briangunderson/ROScar1/docs/chassis/fusion360/bracket_stls/motor_bracket_25GA20E260.stl

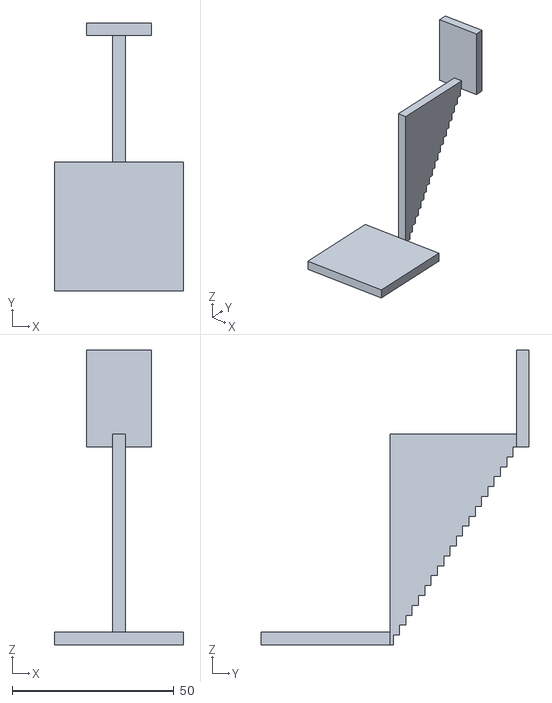
[picture p1: CAD file, 2026-04-20]
docs/chassis/fusion360/bracket_stls/motor_bracket_25GA20E260.stl
40.0 x 83.0 x 91.2
