briangunderson/ROScar1/docs/chassis/models/brackets/L-Plate 3030 5 Holes - M6.step

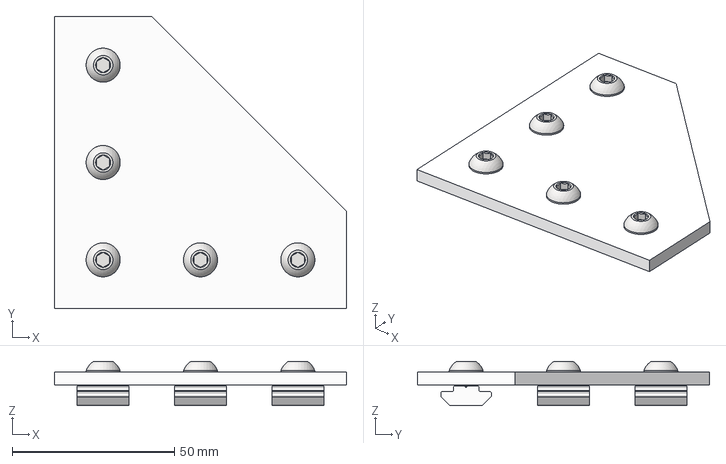
[picture p2: CAD file, 2026-04-17]
docs/chassis/models/brackets/L-Plate 3030 5 Holes - M6.step
90.0 x 90.0 x 13.6 mm
Slider T-Nut for 3030 - M6 x 5
M6x1x10mm - Button Head Hex Drive Screw x 5
