briangunderson/ROScar1/docs/chassis/models/extrusions/30X30 - T-slot - Aluminium Profile.step

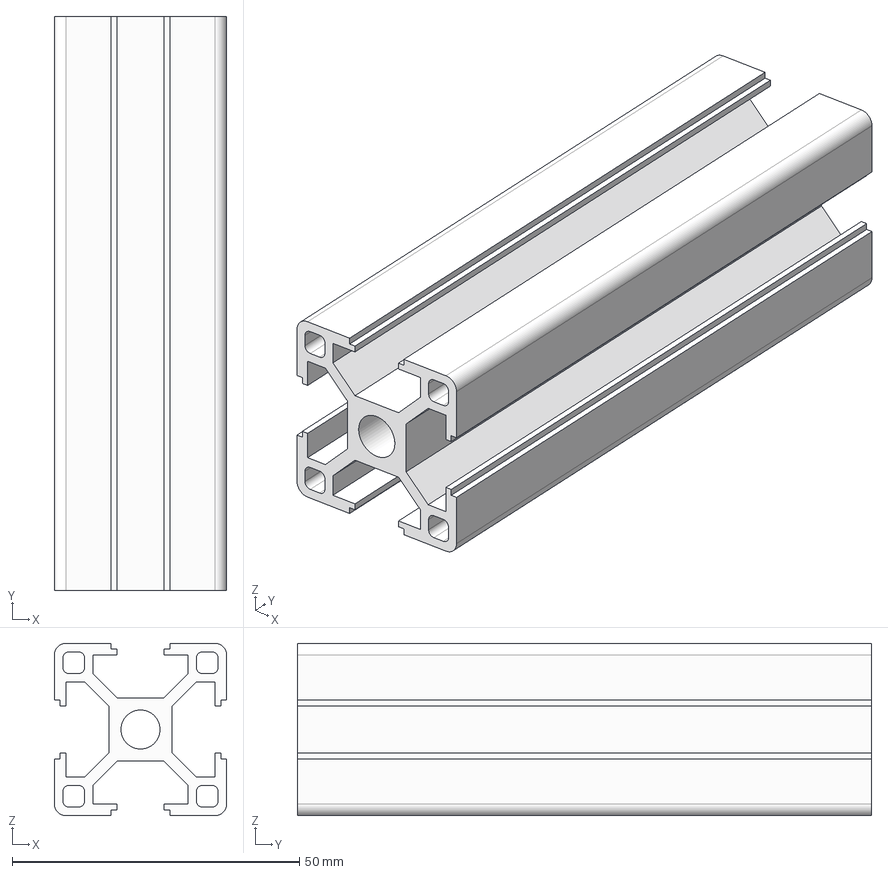
[picture p3: CAD file, 2026-04-17]
docs/chassis/models/extrusions/30X30 - T-slot - Aluminium Profile.step
30.0 x 100.0 x 30.0 mm
