briangunderson/ROScar1/docs/chassis/models/brackets/T-Plate 3030 5 Holes - M5.step

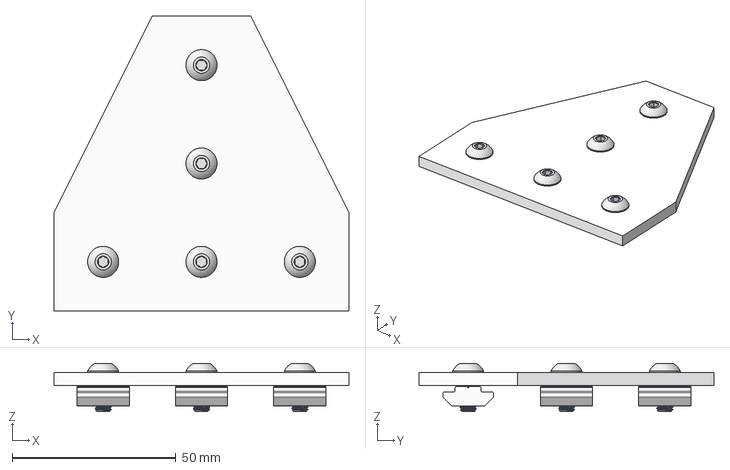
[picture p4: CAD file, 2026-04-17]
docs/chassis/models/brackets/T-Plate 3030 5 Holes - M5.step
90.0 x 90.0 x 14.8 mm
Slider T-Nut for 3030 - M5 x 5
M5x0.8x12mm - Button Head Hex Drive Screw x 5
