briangunderson/ROScar1/docs/chassis/models/brackets/3030 - 3-way corner bracket.step

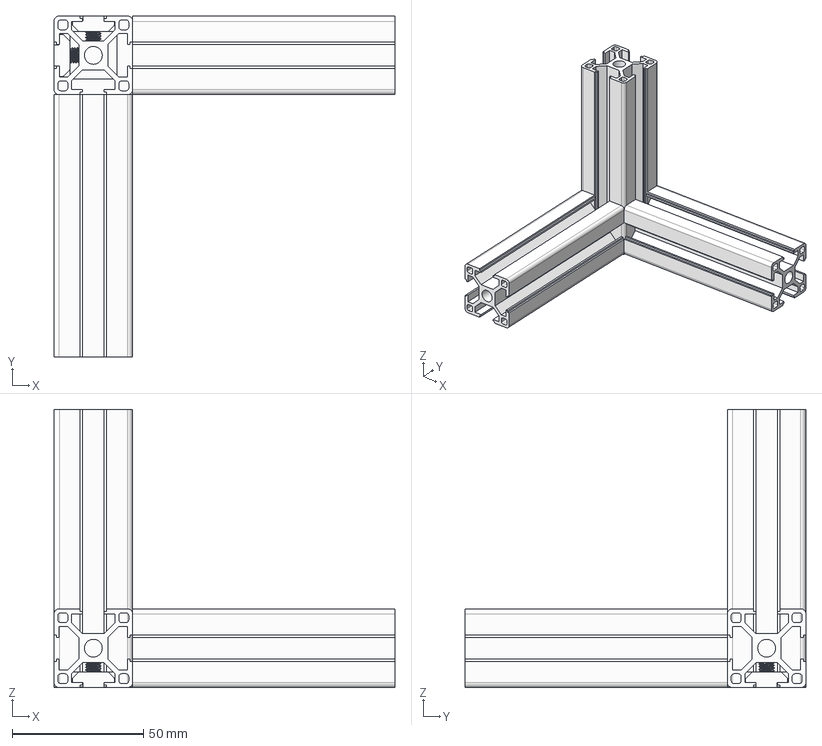
[picture p5: CAD file, 2026-04-17]
docs/chassis/models/brackets/3030 - 3-way corner bracket.step
130.0 x 130.0 x 106.0 mm
M6x1x10 - Flat-Tip Set Screw (1) x 4
30X30 - T-slot - aluminium profile_1 x 3
