briangunderson/ROScar1/docs/chassis/models/brackets/T-Plate 3030 5 Holes - M6.step

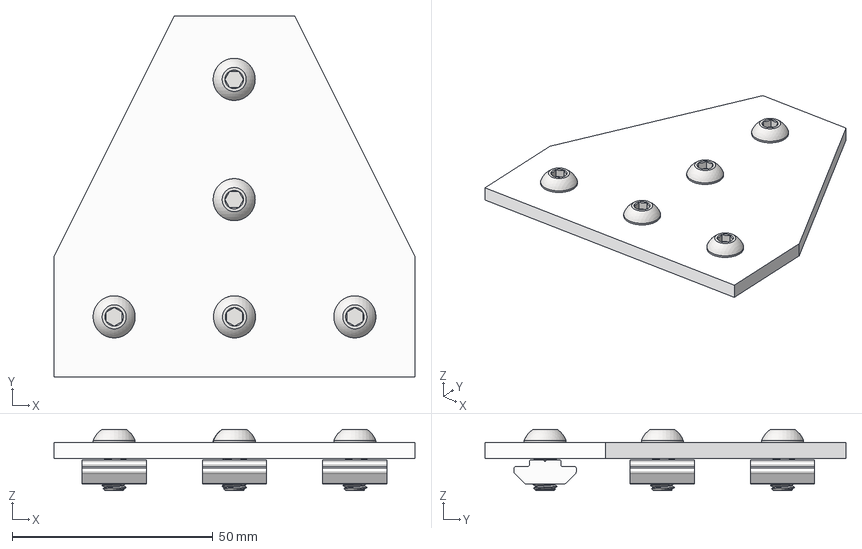
[picture p6: CAD file, 2026-04-17]
docs/chassis/models/brackets/T-Plate 3030 5 Holes - M6.step
90.0 x 90.0 x 15.3 mm
M6x1x12mm - Button Head Hex Drive Screw x 5
Slider T-Nut for 3030 - M6 x 5
