briangunderson/ROScar1/docs/chassis/models/fasteners/Slider T-Nut for 3030 - M3.step

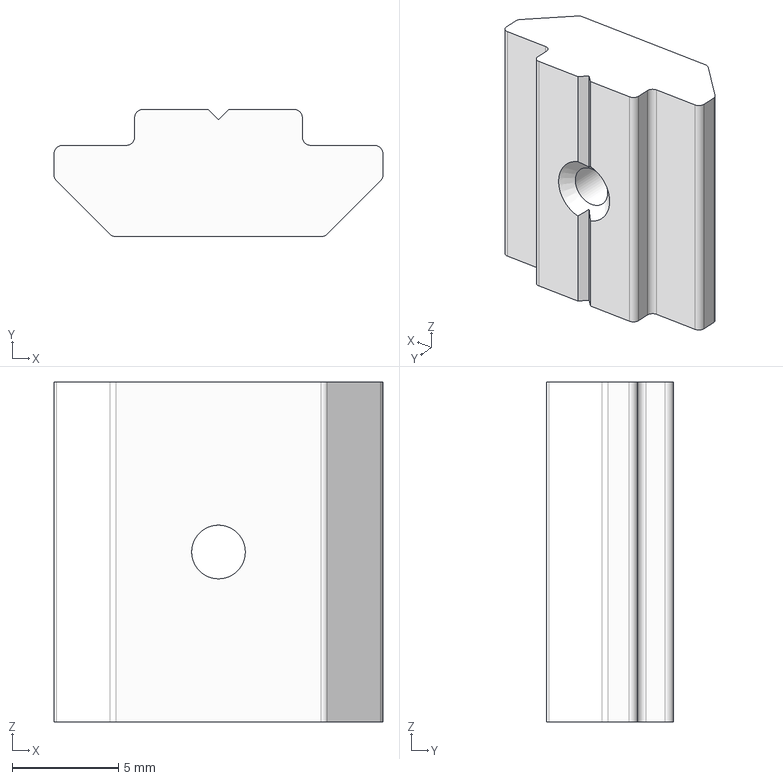
[picture p8: CAD file, 2026-04-17]
docs/chassis/models/fasteners/Slider T-Nut for 3030 - M3.step
15.5 x 6.00 x 16.0 mm
