briangunderson/ROScar1/(list of files, cad)

Other CAD files:
docs/chassis/models/fasteners/Slider T-Nut for 3030 - M5.step
docs/chassis/models/fasteners/Slider T-Nut for 3030 - M6.step
docs/chassis/models/brackets/3030 - 3-way corner bracket.iges
docs/chassis/models/brackets/L-Plate 3030 5 Holes - M6.iges
docs/chassis/models/brackets/T-Plate 3030 5 Holes - M5.iges
docs/chassis/models/brackets/T-Plate 3030 5 Holes - M6.iges
docs/chassis/models/extrusions/30X30 - T-slot - Aluminium Profile.f3d
docs/chassis/models/extrusions/30X30 - T-slot - Aluminium Profile.iges
docs/chassis/models/fasteners/Slider T-Nut for 3030 - M3.f3d
docs/chassis/models/fasteners/Slider T-Nut for 3030 - M3.iges
docs/chassis/models/fasteners/Slider T-Nut for 3030 - M4.f3d
docs/chassis/models/fasteners/Slider T-Nut for 3030 - M4.iges
docs/chassis/models/fasteners/Slider T-Nut for 3030 - M5.f3d
docs/chassis/models/fasteners/Slider T-Nut for 3030 - M5.iges
docs/chassis/models/fasteners/Slider T-Nut for 3030 - M6.f3d
docs/chassis/models/fasteners/Slider T-Nut for 3030 - M6.iges
