briangunderson/ROScar1/tasks/todo.md

# ROScar1 - Task Tracker

## Milestone 1: Teleop Ready ✅
- [x] Create workspace structure
- [x] roscar_driver package (driver node, kinematics, config, launch)
- [x] roscar_description package (URDF, launch, rviz)
- [x] roscar_bringup package (launch files, teleop config, EKF config)
- [x] Setup scripts (RPi setup, udev rules)
- [x] CLAUDE.md project documentation
- [x] Deploy to RPi5 and test
- [x] Rosmaster_Lib v3.3.9 installed (pip from github.com/Roblibs/Rosmaster_Lib)
- [x] All 6 nodes running: driver, robot_state_publisher, joint_state_publisher, sllidar, imu_filter, ekf
- [x] Teleop driving confirmed working

## Milestone 2: Camera Integration ✅
- [x] v4l2_camera launch (fixed image_size param type — OpaqueFunction for int cast)
- [x] Camera link in URDF (camera_link + camera_optical_frame already in xacro)
- [x] Test image streaming (/image_raw at 30fps, /camera_info publishing)

## Milestone 3: Sensor Fusion ✅
- [x] Fix IMU sign conventions (negate all accel axes, negate only gx/gy for gyro)
- [x] Fix conflicting odom TFs (driver publish_odom_tf=false, EKF owns TF)
- [x] EKF config: velocity-only from odom, 20Hz, differential IMU yaw
- [x] IMU Madgwick filter: fixed_frame=odom, gain=0.1, orientation correct (flat=identity)
- [x] Verified: 0 NaN errors, position stable at origin when stationary, all topics 20Hz

## Milestone 4: SLAM + Navigation
- [x] slam_toolbox config (online_async, 5cm resolution, RPLIDAR C1 tuned)
- [x] Nav2 config (DWB holonomic controller, SmacPlanner2D, AMCL OmniMotionModel, RPi5-tuned)
- [x] slam.launch.py (SLAM-only mapping with teleop)
- [x] navigation.launch.py (saved map + AMCL + Nav2)
- [x] slam_nav.launch.py (SLAM + Nav2 combined for explore-and-navigate)
- [x] Package deps updated (slam_toolbox, navigation2, nav2_bringup)
- [x] setup_rpi.sh updated with new apt packages
- [x] Deploy to RPi5 and test SLAM mapping (lifecycle fix: nav2_lifecycle_manager + bond_timeout=0.0)
- [x] SLAM verified: /map publishing (74×135 cells @ 5cm), map->odom TF, all 8 nodes running
- [ ] Save first map and test Nav2 navigation
- [ ] Verify holonomic motion (strafing) during navigation
