briangunderson/ROScar1/roscar_ws/src/roscar_web/config/web_params.yaml

rosbridge_websocket:
  ros__parameters:
    port: 9090
    address: "0.0.0.0"
    retry_startup_delay: 5.0
    fragment_timeout: 600
    delay_between_messages: 0.0
    max_message_size: 10000000
    unregister_timeout: 10.0

web_video_server:
  ros__parameters:
    port: 8080
    address: "0.0.0.0"
    default_stream_type: "mjpeg"
    ros_threads: 2

http_server:
  ros__parameters:
    port: 8888
