briangunderson/ROScar1/(commit log)

2026-03-02 Milestone 1: Teleop-ready ROS2 workspace for 4WD Mecanum robot
    Complete ROS2 Jazzy workspace with three packages:
    - roscar_driver: Python node bridging cmd_vel/sensors to YB-ERF01-V3.0
    via Rosmaster_Lib (serial 115200). Publishes odom, IMU, battery.
    - roscar_description: URDF (placeholder dims) with mecanum wheels,
    camera, IMU, and RPLIDAR C1 laser frames.
    - roscar_bringup: Launch files for teleop, robot bringup (driver +
    lidar + Madgwick IMU filter + EKF), and camera.
    Includes RPi5 setup script, udev rules for motor board + RPLIDAR C1,
    and EKF/IMU filter configurations.
    [roscar.urdf.xacro]
2026-03-02 Fix forward direction: board X-axis is 180° from physical front
    Camera and lidar are mounted on the board's rear. Negate vx/vy at the
    hardware boundary (commands to board and sensor data from board) so that
    ROS +X points toward the camera/lidar. Angular-z and vertical axes are
    unaffected by a yaw-only rotation.
2026-03-02 Fix reversed turning: negate wz for swapped L/R motor ports
    Translation (vx, vy) was correct but rotation was reversed, indicating
    the left/right motor pairs are swapped on the board's ports. Negate wz
    in commands and odometry, and gz in gyro data to compensate.
2026-03-02 Update lessons with final motor wiring notes
    All axes negated at hardware boundary: board is mounted 180° rotated
    AND motor L/R ports are swapped. Confirmed driving correctly in all
    directions including rotation.
2026-03-02 Fix camera.launch.py image_size parameter type error
    v4l2_camera expects image_size as integer_array, but LaunchConfiguration
    substitutions resolve to strings. Use OpaqueFunction to cast to int.
2026-03-02 Mark Milestone 2 complete, add camera + launch file lessons
    Camera integration verified: /image_raw at 30fps, /camera_info publishing.
    Added lessons about v4l2_camera parameter typing and OpaqueFunction pattern.
2026-03-02 Fix sensor fusion: IMU signs, conflicting TFs, EKF config
    - Accel: negate all 3 axes (Rosmaster_Lib reports gravity as -Z,
    ROS expects +9.81 when flat)
    - Gyro: only negate gx, gy (180-deg yaw rotation); keep gz as-is
    (Z-axis direction unchanged by yaw rotation)
    - Disable driver's odom TF (publish_odom_tf: false); EKF now owns
    the odom->base_footprint transform
    - EKF: use velocity-only from odom (position was double-counting),
    lower frequency to 20Hz to avoid rate warnings on Pi
    - IMU filter: fix fixed_frame from base_link to odom
    Previous bugs: Madgwick saw az=-9.8 and concluded robot was upside
    down (180-deg roll), feeding garbage orientation to EKF which went
    NaN. Negated gz also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
2026-03-02 Mark Milestone 3 complete, update docs with sensor fusion details
    All sensor fusion issues resolved: IMU signs corrected (accel z, gyro z),
    conflicting TFs eliminated, EKF velocity-only odom fusion. Verified:
    0 NaN errors, stable position when stationary, all topics at 20Hz.
2026-03-03 Add SLAM + Nav2 configuration (Milestone 4)
    - slam_toolbox online_async config (5cm resolution, RPLIDAR C1 tuned)
    - Nav2 params: DWB holonomic controller, SmacPlanner2D, AMCL OmniMotionModel
    - Three launch modes: slam.launch.py, navigation.launch.py, slam_nav.launch.py
    - RPi5-tuned frequencies (controller 10Hz, costmaps 5Hz/1Hz)
    - Updated package deps, setup script, and documentation
2026-03-03 Add web dashboard: roscar_interfaces + roscar_web packages
    New packages:
    - roscar_interfaces: custom .srv files (SetMode, SaveMap, GetStatus)
    - roscar_web: web dashboard with rosbridge/video/http nodes + full frontend
    Frontend (vanilla JS, no build step):
    - Industrial mission-control aesthetic (dark navy + cyan)
    - Drive tab: dual nipplejs joystick (holonomic vx/vy/wz) + keyboard WASD/QE
    - Camera tab: MJPEG stream from web_video_server
    - Map tab: OccupancyGrid canvas renderer + robot pose + click-to-navigate
    - Status tab: odometry, IMU, battery gauge, active node list
    - Settings tab: mode switching (idle/teleop/slam/nav/slam_nav), map save
    - E-STOP button + Spacebar shortcut
    Backend:
    - laun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
    [web_params.yaml]
2026-03-03 Fix rosbridge param: delay_between_messages must be DOUBLE (0.0 not 0)
    [web_params.yaml]
2026-03-03 fix(web): rotate map view 90° CCW so forward (ROS +X) points UP
    The OccupancyGrid renderer was mapping ROS +X to screen RIGHT, causing
    the robot arrow to appear to move side-to-side when driving forward.
    Now forward→UP, left→LEFT matching standard top-down robot view.
    Changed: drawMap canvas transform, drawRobotPose world-to-screen,
    fitMapToCanvas dimension swap, sendNavGoal inverse transform.
2026-03-03 fix(driver): add gyro bias calibration to eliminate yaw drift
    MEMS gyroscopes have a small non-zero offset when stationary. Without
    compensation, this bias integrates through Madgwick + EKF into continuous
    yaw drift. Samples gyro at ~100Hz for 2s at startup (configurable via
    gyro_cal_seconds param), computes mean bias, subtracts it from all
    subsequent readings before the 180° rotation correction.
2026-03-03 feat(driver): add yaw_trim parameter for steering correction
    Compensates for mechanical pull (uneven wheel friction, motor mismatch,
    weight distribution) when driving straight. Trim is proportional to
    forward speed so it scales naturally and reverses when backing up.
    Tunable at runtime: ros2 param set /roscar_driver yaw_trim <value>
2026-03-06 fix(nav2): add laser range filter to eliminate chassis self-reflections
    RPLIDAR C1 sees ~145 scan points from robot chassis at 0.02-0.09m range,
    which slam_toolbox bakes into the map as permanent obstacles at the robot
    position, causing Nav2 planner "Start occupied" errors.
    - Add laser_filter.yaml: LaserScanRangeFilter drops returns < 0.15m
    - Modify robot.launch.py: sllidar publishes /scan_raw, laser_filter_node
    filters and republishes as /scan
    - Fix URDF laser joint: add pi yaw for 180-deg mounted RPLIDAR
    - Add rviz2 Tools section: 2D Goal Pose, SetInitialPose, etc.
    - Set obstacle_min_range: 0.20 on both costmap obstacle layers
    [roscar.urdf.xacro]
2026-03-06 fix(laser_filter): use ROS2 param YAML format instead of sequence
    laser_filters scan_to_scan_filter_chain expects ros__parameters with
    numbered filter keys (filter1, filter2), not YAML list syntax.
2026-03-06 docs: add laser filter and nav2 goal testing lessons
    - Document lidar self-reflection filtering with laser_filters
    - Document Nav2 progress checker tuning for slow robots
    - Update CLAUDE.md: nav2 goal verified, laser_filter in critical files
    - Add scan_raw/scan pipeline to topics table
2026-03-06 fix(nav2): expand collision_monitor polygons to prevent false stops
    The PolygonStop zone matched the robot footprint exactly (0.15m), causing
    nearby wall returns at 0.15-0.20m to trigger emergency stops on every
    navigation attempt. Expanded to 0.20m with min_points=8, and added a
    PolygonSlow zone at 0.30m for gradual deceleration near obstacles.
2026-03-06 feat(nav2): triple velocity limits for faster navigation
    DWB and velocity_smoother limits tripled: max_vel_x 0.5→1.5,
    max_vel_y 0.3→0.9, max_vel_theta 2.0→4.0, accel limits raised to match.
2026-03-06 feat: update for top-mounted lidar — remove laser filter
    Lidar moved from middle platform to top platform with clear 360-degree
    view. Updated URDF lidar_z (0.12→0.09), removed laser_filter_node from
    robot.launch.py (no more chassis self-reflections), and reset costmap
    obstacle_min_range to 0.0.
    [roscar.urdf.xacro]
2026-03-06 fix(nav2): dial back velocity to safe levels (0.8 m/s max)
    1.5 m/s was too aggressive — robot crashed into desk. Reduced to 0.8 m/s
    forward, 0.5 m/s strafe, 3.0 rad/s rotation. Still ~60% faster than the
    original 0.5/0.3/2.0 defaults.
2026-03-11 fix: motor wiring corrections, EKF bypass Madgwick, decel limiter, web dashboard improvements
    Motor wiring physically corrected — all 4 motors now match board port labels
    with correct polarity. Driver simplified: removed all cmd_vel and odometry
    sign corrections. Added deceleration limiter to prevent tip-overs on abrupt stops.
    EKF now uses imu/data_raw directly (bypasses broken Madgwick orientation).
    Driver sets identity quaternion on imu/data_raw so robot_localization's
    frame transform is a no-op. Negates all 3 gyro axes (gz firmware inversion).
    Web dashboard: added rosapi node for getNodes(), fixed camera.js URL encoding
    bug (web_video_server doesn't decode %2F), updated roslibjs, adde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
    [motor_test.py]
2026-03-11 docs: add AIO dashboard implementation plan
    12-task plan covering HTML skeleton, CSS Grid, all 8 JS modules
    (app, teleop+gamepad, camera, status+modes, map, lidar, graphs,
    diagnostics, TF tree), integration testing, and docs.
2026-03-11 feat(aio): add HTML skeleton and CSS Grid layout
    Create the AIO (all-in-one) mission-control dashboard with a 3-column,
    2-row CSS Grid layout showing all panels simultaneously. Includes:
    - Camera feed panel with quality/resolution controls
    - Map panel with canvas, zoom controls, and nav goal UI
    - Status panel with position/velocity/orientation/battery/mode/map-save
    - Drive panel with dual joystick zones, sliders, kbd hints, lidar canvas
    - Telemetry panel with 4 sparkline canvases and TF tree section
    - Diagnostics panel with severity filter and scrollable log container
    - Shared: E-STOP button, toast notifications, scanline CRT overlay
    CSS is standalone (no style.css import), uses same indust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
2026-03-11 feat(aio): add MJPEG camera stream panel
2026-03-11 feat(aio): add status readouts, mode switching, and map save
2026-03-11 feat(aio): add lidar mini-radar panel
2026-03-11 fix(web): AIO dashboard integration bugs — nav goal wiring, CSS class, message types
    - Wire enableNavGoalMode from aio-map to onNavModeChange in aio-status via aio-app
    - Fix status message CSS class ('mode-status-msg' → 'status-msg')
    - Fix rosout message type ('rcl_interfaces/msg/Log' → 'rcl_interfaces/Log')
    - Fix TF message type ('tf2_msgs/msg/TFMessage' → 'tf2_msgs/TFMessage')
    - Remove unused HOST import from aio-status
    - Fix initStatus() call (was passing unnecessary getRos arg)
2026-03-11 fix(web): camera quality/resolution buttons not rebuilding stream URL
    Two issues fixed in aio-camera.js:
    1. Button clicks only called startStream() when `streaming` was true.
    Since the AIO dashboard camera panel is always visible (no tab switch),
    if the initial connection failed or hadn't completed yet, clicking
    quality/resolution buttons would update the JS state and active class
    but never actually rebuild the MJPEG stream URL. Now startStream() is
    called unconditionally on every button click.
    2. JS default values (quality=50, resolution=640x480) didn't match the
    HTML active buttons (quality=20/L, resolution=320x240). This meant
    the initial stream URL used different s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
2026-03-11 fix(web): fetch current mode on connect so UI survives page refresh
    On page load/refresh the AIO dashboard defaulted to showing "idle" mode
    even when the robot was running in another mode (e.g. slam_nav). Added a
    /web/get_status service call in setupServices() that runs on every
    rosbridge connect event, syncing the mode display, button active state,
    and nav-goal enablement with the actual launch_manager state.
2026-03-11 fix(web): remove CRT scanline overlay from camera panel
    The body::after scanline effect (z-index: 9999) was bleeding into
    the camera feed. Lift #panel-camera above the overlay with
    z-index: 10000 so the video stream renders clean.
2026-03-11 fix(web): zoom map toward mouse cursor instead of top-left corner
    Scroll-wheel zoom now adjusts viewOffset so the world point under the
    cursor stays fixed, giving natural zoom-to-cursor behavior. Zoom-in
    and zoom-out buttons use the same logic targeting the canvas center.
    Extracted a shared zoomAtPoint(factor, cx, cy) helper that computes
    the world coordinate under the given canvas point, applies the scale
    factor, then re-derives the offset to keep that point anchored.
2026-03-11 fix(web): use SLAM-corrected pose for map robot overlay
    Add ROSLIB.TFClient subscribing to the map->odom->base_footprint
    TF chain so the robot arrow on the map stays aligned with the
    SLAM-corrected pose instead of drifting with raw EKF odometry.
    When SLAM is running, slam_toolbox publishes a map->odom correction
    that /odometry/filtered doesn't include. The TFClient automatically
    composes the full chain. Falls back to /odometry/filtered when the
    map frame isn't available (e.g. no SLAM running).
2026-03-11 feat(web): add Reset Map button to AIO dashboard
    Cycles SLAM mode (idle → restore) to restart slam_toolbox with a fresh
    map. Clears local map data immediately for responsive UI feedback.
    Only enabled when in SLAM or SLAM+NAV modes.
2026-03-11 fix(web): move scanline overlay to per-panel ::after, exclude camera
    body::after with position:fixed creates a stacking context that can't
    be overridden by z-index on grid children. Instead, apply scanlines
    via .panel::after on each panel and disable on #panel-camera.
2026-03-11 feat(web): add robot-locked map view with heading-up rotation
    Toggle (lock icon) on the map panel switches between free pan/zoom and
    robot-centered mode where the robot is fixed at canvas center always
    facing up. The map rotates underneath to match the robot's heading,
    like a car GPS. Zoom still works; pan is disabled while locked.
    Nav2 click-to-navigate accounts for the rotated view transform.
2026-03-11 fix(web): use text label for map lock button instead of emoji
    Emoji glyphs may not render in the Rajdhani/Share Tech Mono font stack.
    Use plain 'L' with .active class highlight to indicate locked state.
2026-03-13 docs: add SpaceMouse teleop integration design spec
    WebHID-based 6DOF SpaceMouse Wireless support for AIO dashboard.
    Covers HID protocol, axis mapping, sensitivity curves, priority
    system, E-STOP, secure context workaround, and right joystick fix.
2026-03-13 fix(spacemouse): correct inversion toggle mapping and settings panel ID
    - sm_invert_x now correctly inverts vx (fwd/back), sm_invert_y inverts vy (strafe)
    - Settings panel ID changed to 'sm-settings' to match HTML markup
    - Removed duplicate connect button handler (aio-app.js owns this)
2026-03-13 feat(spacemouse): add UI elements and styles for connect button and settings panel
2026-03-13 fix: address code review findings across SpaceMouse integration
    - Fix right joystick vx clobbering left joystick by separating joyL/joyR
    state objects and summing contributions in publishVelocity()
    - Fix inconsistent indentation in aio-app.js (SM button handler + init)
    - Debounce E-STOP to fire only on rising edge (0→non-zero transition),
    preventing repeated calls while button is held
    - Rescale post-deadzone axis range for smooth zero-to-moving transition
    (was: jump from 0 to deadzone/AXIS_MAX; now: smooth 0 to 1)
    - Remove dead sm-status markup and unused .sm-tag CSS rule
    - Add unit suffixes (m/s, rad/s) to speed slider display values
    - Show device name in connect button text via onC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
2026-03-14 fix(boot): ensure web dashboard survives RPi5 power cycle
    The roscar-web service was crashing on boot because network-online.target
    fires before an IP is assigned, causing CycloneDDS to fail to bind.
    Additionally, ros2 launch exits with code 0 when all child nodes die,
    so Restart=on-failure never triggered a retry.
    - Add network readiness loop (up to 30s) before launching ROS2 nodes
    - Change Restart=on-failure to Restart=always with burst limits
    - Add .gitattributes to enforce LF line endings for Linux scripts
2026-03-14 fix(boot): ensure web dashboard survives RPi5 power cycle
    The roscar-web service was crashing on boot because CycloneDDS couldn't
    initialize — network-online.target fires before DDS can bind, causing
    all ROS2 nodes to fail with "error creating node".
    - Add network readiness loop (waits for default route, up to 30s)
    - Add DDS probe that verifies a ROS2 node can be created before
    launching the full stack (waits up to 30s for DDS to be ready)
    - Change Restart=on-failure to Restart=always with burst limits,
    since ros2 launch exits code 0 even when all child nodes die
    Verified: all 5 nodes start cleanly after cold boot.
    Co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
2026-03-14 feat(web): add sci-fi HUD lidar depth overlay on camera feed
    Projects /scan points within the camera's ~60° FOV onto a canvas overlay,
    rendering depth-coloured bars (red→cyan by distance), a proximity warning
    vignette, nearest-object callout with distance label, sweep animation,
    and HUD chrome (corner brackets, crosshair, FOV label). Toggleable via
    DEPTH button in camera controls.
2026-03-14 feat(web): add clipboard copy and clear to AIO diagnostics panel
    Click any log entry to copy it, COPY button for all visible logs,
    CLR button to clear. Includes fallback for non-HTTPS contexts.
2026-03-14 Add camera calibration data and auto-load in launch
    Logitech webcam (046d:0825) calibrated via ros2 camera_calibration
    with 61 checkerboard images. camera.launch.py now passes
    camera_info_url to v4l2_camera so /camera_info publishes accurate
    intrinsics (fx=924, fy=920, cx=357, cy=253, plumb_bob distortion).
    [camera_calibration.yaml]
2026-03-14 Fix camera calibration name and add io_method for RPi5
    - camera_name must match v4l2 device ID: uvc_camera_(046d:0825)
    - Add io_method=read to avoid YUYV mmap failures on RPi5
    - Verified: /camera_info publishes correct intrinsics and distortion
    [camera_calibration.yaml]
2026-03-14 docs: mark camera calibration and feed fix complete in CLAUDE.md
2026-03-15 Fix EKF divergence: use ROS -1 covariance convention for unused IMU data
    The EKF was exploding (angular.z reaching 10M+ rad/s) because
    robot_localization processed orientation and acceleration data through
    internal code paths (gravity removal, frame transforms) even when those
    fields were disabled in imu0_config.
    Fixes:
    - Set orientation_covariance[0] = -1 (ROS convention: "no orientation data")
    This explicitly tells robot_localization to skip ALL orientation processing
    - Set linear_acceleration_covariance[0] = -1 ("no accel data")
    Prevents internal accel processing paths from executing
    - Set imu0_remove_gravitational_acceleration: false
    Eliminates gravity removal code path (documente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
2026-03-15 Fix camera defaults, robot indicator, and add CV design doc
    - Camera defaults: quality 80 (high), resolution 640x480, matching HTML active states
    - Robot indicator: add TF staleness detection (3s timeout → odom fallback),
    validate TF translations, skip drawing when robot is far outside map grid
    - CV design: approved architecture for ArUco + YOLO on remote RTX 4070 PC
2026-03-15 feat(cv): add aio-cv.js dashboard module with feed toggle and detection overlay
    - New aio-cv.js: subscribes to /detections, shows object summary overlay,
    provides RAW/CV toggle button to switch camera feed topic
    - aio-camera.js: topic now dynamic, listens for cv-feed-change CustomEvent
    - aio-app.js: imports and initializes CV module
    - aio.html: CV toggle button + detection overlay element in camera panel
    - aio.css: detection overlay styling (green text on dark background)
2026-03-15 fix(web): rework lidar depth overlay for cleaner, professional look
    - Remove sci-fi HUD chrome: corner brackets, crosshair, sweep animation,
    FOV label, L/R labels, bottom distance scale
    - Remove pulsing red proximity vignette, replace with subtle edge tint
    - Remove "NEAREST" tag, replace with clean distance pill label
    - Add EMA smoothing to nearest-object callout to prevent jitter
    - Only show nearest label when object is within 2m
    - Restyle color ramp: warm white (close) → light blue → dim steel (far)
    - Thinner bars, subtler opacity, cleaner centre strip
    - Remove drawHUDFrame and drawCorner functions entirely
2026-03-15 fix(web): correct lidar overlay HFOV from 60° to 38.1° using calibration
    HFOV was hardcoded at 60° (a guess). Actual value from camera calibration
    is 2*atan(320/924) ≈ 38.1° (fx=924 at 640px width). This significantly
    improves horizontal alignment of lidar bars to objects in the camera feed.
2026-03-15 feat(slam): add landmark localizer and tune slam_toolbox for drift reduction
    - Add ArUco marker-based pose correction node (landmark_localizer) that
    auto-learns marker positions and publishes /initialpose corrections
    when SLAM drift exceeds threshold
    - Tune slam_toolbox: tighter scan matching (0.2m/0.2rad), faster processing
    (3Hz), reduced laser range (8m), wider loop closure search (4m)
    - Add landmark_localizer to slam.launch.py
    - Document landmark system and slam_toolbox tuning in CLAUDE.md
2026-03-16 fix(landmark): use camera_optical_frame for correct marker map positions
    The ArUco detector returns poses in OpenCV's optical frame convention
    (x=right, y=down, z=forward) but labels them as camera_link. Previously
    we manually converted optical→camera_link coordinates, which placed
    markers in the wrong location on the map (behind/side of robot instead
    of in front).
    Fix: look up map→camera_optical_frame TF instead of map→camera_link.
    The URDF already defines the optical→camera_link rotation via the
    camera_optical_joint (rpy=-π/2, 0, -π/2), so the TF tree handles
    the coordinate conversion automatically.
    Also:
    - Add /landmark/clear_markers service (std_srvs/Trigger) for dashboard
    -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
2026-03-16 docs: add lessons from landmark localizer debugging session
    Key lessons:
    - Use camera_optical_frame (not camera_link) for OpenCV coordinate TF
    - CycloneDDS MaxAutoParticipantIndex must be >10 for SLAM+Nav2 stacks
    - slam_toolbox online_async has zero /initialpose subscribers, use EKF /set_pose
    - SLAM restart creates new map frame, don't load old learned markers
    - 6s delay needed between SLAM restarts (old nodes take 5s to terminate)
2026-03-16 fix(urdf): replace placeholder dimensions with real measurements
    Measured 2026-03-16 with calipers and tape measure:
    - Wheelbase: 96.55mm (was 200mm placeholder)
    - Track width: 205mm (was 240mm)
    - Wheel radius: 39.7mm (was 33mm)
    - Wheel width: 37.3mm (was 40mm)
    - Ground clearance: 20.5mm (was 50mm)
    - Total mass: 2.2kg (was 2.8kg estimate)
    Also update Nav2 footprint to match real 290x245mm envelope
    (was 250x280mm placeholder). Camera and LIDAR positions still
    need precise measurement.
    https://claude.ai/code/session_01YF2vokRcTutCeDgSXu9grD
    [roscar.urdf.xacro]
2026-03-16 fix(map): use direct /tf subscription for map-frame robot pose
    Replace ROSLIB.TFClient (requires tf2_web_republisher, broken on Jazzy)
    with direct /tf topic subscription. Extract map→odom transform and apply
    it to /odometry/filtered position to get correct map-frame robot pose.
    Fixes arrow showing in wrong position on the SLAM map.
2026-03-16 feat(web): replace nav map text input with dropdown selector
    Add ListMaps service that scans ~/maps/ for saved .yaml files and
    returns them to the frontend. The NAV mode button now shows a styled
    dropdown populated via ROS service call instead of requiring manual
    path entry.
2026-03-16 fix(cv): fix YOLO detector and CV feed pipeline for Jazzy
    Three root causes fixed:
    - YOLO node used wrong vision_msgs API (hyp.id → hyp.hypothesis.class_id)
    - classes parameter declaration crashed with empty list (use INTEGER_ARRAY type)
    - Added BEST_EFFORT QoS and frame counting for cross-machine image subscription
    - cv.launch.py adds web_video_server on port 8081 for CV stream serving
    - ArUco detector tuned for longer range (minMarkerPerimeterRate, adaptive
    threshold, corner refinement, error correction)
    - Dashboard aio-app.js adds CV_HOST/CV_PORT config for remote CV video server
    - Dashboard aio-camera.js routes CV feeds to GPU PC's video server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
2026-04-11 feat(chassis): add 3030 T-slot CAD models for chassis v2 build
    Copies relevant hardware models from local library into the repo so they
    live alongside the Fusion 360 script and design spec. Organized by type:
    docs/chassis/models/
    ├── extrusions/ 30X30 T-slot profile (F3D, IGES, STEP)
    ├── brackets/ 3-way corner bracket, T-plate M5/M6, L-plate M6
    └── fasteners/ Slider T-nuts for 3030, M3–M6 (F3D, IGES, STEP)
    Also adds a README explaining the directory layout, which models map to
    which BOM items, preferred file formats, and F360 import workflow.
    CLAUDE.md updated: Critical Files table now lists the chassis script,
    models directory, and session handoff do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
    [3030 - 3-way corner bracket.iges, 3030 - 3-way corner bracket.step, 30X30 - T-slot - Aluminium Profile.f3d, 30X30 - T-slot - Aluminium Profile.iges, 30X30 - T-slot - Aluminium Profile.step, L-Plate 3030 5 Holes - M6.iges, L-Plate 3030 5 Holes - M6.step, Slider T-Nut for 3030 - M3.f3d]
2026-04-11 feat(chassis): chassis v2 design spec, Fusion 360 script, and related fixes
    Chassis v2 design work (parallel to main codebase — no existing nodes changed):
    - docs/superpowers/specs/2026-04-04-extrusion-chassis-design.md: Full design
    spec — two-deck 3030 extrusion frame, CoG analysis, BOM, cut plan, fab phases
    - docs/superpowers/plans/2026-04-04-fusion360-chassis-mockup.md: Implementation
    plan for the Fusion 360 parametric model
    - docs/chassis/fusion360/roscar_v2_chassis.py: Fusion 360 API script (rev8b) —
    procedural model with colors, T-slot profiles, motors below frame on L-brackets,
    segmented mecanum wheels, RPi5/lidar/camera stand-ins
    - docs/chassis/fusion360/README.md: How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
    [roscar_v2_chassis.py]
2026-04-12 feat(chassis): import real STEP models into Fusion 360 script (rev9)
    Replace procedural T-slot polygon extrusions with imported STEP files:
    - 3030 extrusion profiles (non-uniform scaled to rail/post/mast lengths)
    - 3-way corner brackets at all 8 frame-to-post junctions
    - T-plate bracket for lidar mast attachment
    - Remove TZ() procedural function and TSL_W/TSL_D/BORE_R constants
    New helpers: _import_step(), _place(), _scale_y(), _clr_occ(),
    _import_rail() for the import-scale-position-color workflow.
    Electronics, motors, wheels, plates, wiring remain procedural.
    Bracket rotations may need visual adjustment after first test run.
    [roscar_v2_chassis.py]
2026-04-17 fix(chassis): rev10 — correct bracket rotations, explicit transforms, instance reuse
    Four fixes and one performance optimization over rev9:
    1. Upper-deck bracket Z-arm now points DOWN (was incorrectly UP).
    All 8 corners use explicit 3x3 rotation matrices; upper deck swaps
    X/Y arms to keep determinant +1 (proper rotation, no reflection).
    2. Transform composition replaced with explicit column-vector matrices
    via setWithArray. Removes ambiguity about transformBy composition
    order (unclear whether pre- or post-multiply in Fusion 360 API).
    3. Instance reuse via addExistingComponent: 22 STEP imports reduced to
    6 (long rails, short rails, posts, mast, bracket, T-plate templates)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
    [roscar_v2_chassis.py]
2026-04-17 fix(chassis): rev11 — revert to individual STEP imports
    Instance reuse via addExistingComponent (rev10) caused the 2nd/3rd/4th
    instances of each template to be positioned at master_transform × new_transform
    instead of just new_transform. Result: those instances landed far outside
    the frame (confirmed by user testing rev10 — Rail_LR_188mm:1 correct,
    :2/:3/:4 all floating).
    Root cause is in Fusion 360's addExistingComponent composition semantics
    when the master occurrence's transform has been set — exact mechanism
    unclear without more debugging.
    Fix: each rail/post/bracket/tplate gets its own STEP import via the new
    _import_rail() and _import_bracket() helpers. 22 total imports (~20s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
    [roscar_v2_chassis.py]
2026-04-17 feat(chassis): rev12 — mecanum wheels, frame aluminum, visible fastening
    Refinements to make the chassis read as a connected, assembled machine
    rather than a collection of floating parts:
    VISUAL/GEOMETRY
    - Mecanum wheels now have a proper solid tire + central hub + 8 slanted
    rollers at 45deg (was 6 diagonal boxes that read as random cubes).
    Rollers built via CY() + _move_body_transform() with an explicit
    rotation matrix (det=+1 verified) to place each roller tangent to
    the tire surface at the correct mecanum angle.
    - Frame palette bumped from dark gray to anodized aluminum silver so
    the 3030 skeleton reads as structure instead of disappearing.
    - Corner brackets now gunmetal (was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
    [roscar_v2_chassis.py]
2026-04-17 feat(chassis): rev13 — structural focus for fabrication
    Brian is cutting aluminum extrusions today. Reorienting the model around
    getting the frame geometry right and leaving non-structural bits as
    simple placeholders until we have real component STEPs.
    CRITICAL FIX: cut plan reconciled with CAD geometry
    The design spec's cut plan claimed 8× 248mm frame rails, but the CAD
    has ALWAYS used a box-joint layout with 4× 248mm (front/rear, span full
    frame) + 4× 188mm (left/right, fit between front/rear). Updated spec
    §4.6 to reflect the actual geometry and added a saw-ready cut sheet at
    tasks/chassis-v2-cut-sheet.md with labels, stock mapping, and tolerances.
    Total cuts: 13 piece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
    [roscar_v2_chassis.py]
2026-04-17 fix(chassis): correct track width + total height from CAD audit
    Mathematical audit of the rev13 script against the design spec surfaced
    two errors in the documentation — the CAD was correct; the text was wrong.
    Track width: 435mm, not 320mm
    Spec §4.2 claimed motor offset per side (M_OFF) = 35mm, giving a track
    width of ~320mm. The calculation omitted the 62mm motor body length
    (M_CAN 38mm + M_GBOX 24mm). The actual M_OFF in the CAD is 93.6mm
    (motor body + shaft + half wheel width), giving track width 435mm.
    This is actually BETTER for stability — 4.4× the original polygon
    area vs. 3.2× as originally estimated — but users planning routes
    need to know the real dimension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
2026-04-17 fix(chassis): rev13 palette — black anodized frame + orange motor brackets
    Two small fixes after rendering rev13 in Fusion:
    - Frame color changed from aluminum silver (185,190,200) to black anodized
    (35,37,42) to match the physical stock — Brian's 500mm + 400mm 3030
    sticks are all black. The silver contrasted poorly with the tan deck
    plates from isometric views.
    - Motor L-brackets back to bright orange (was gunmetal) — they pop against
    the dark frame now and visually communicate 'engineering fastener'.
    - Corner brackets stay silver/raw-aluminum as before (matches typical
    commodity 3-way corner brackets).
    - _check_centered() now reads the body's local bounding box instead of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
    [roscar_v2_chassis.py]
2026-04-17 feat(chassis): add Raspberry Pi 5 and RPLIDAR C1 STEP models
    Both official, no-login-required downloads direct from the manufacturers:
    - RaspberryPi5.step (5.5 MB) from raspberrypi.com — real Pi 5 mechanical model
    with connectors, mounting holes, PCB contours
    - rplidar-c1.stp (7.7 MB) from slamtec.com — real RPLIDAR C1 with scan housing
    Integration into the Fusion 360 script (rev14+) will replace the procedural
    placeholder blocks ('RPi5' and 'Lidar_Base/Lidar_Head' respectively) with
    STEP imports positioned at the correct placement offsets.
    Remaining non-structural components (motors, wheels, XT60, camera, battery,
    Argon NEO case) still need GrabCAD sourcing — see electronics/READM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
2026-04-17 feat(chassis): rev14 — integrate real RPi5 and RPLIDAR C1 STEPs
    Swap the procedural RPi5 block and Lidar_Base + Lidar_Head cylinders for
    real STEP imports from the manufacturer CAD files committed in the
    previous commit:
    - STEP_RPI5 = electronics/RaspberryPi5.step (raspberrypi.com)
    - STEP_RPLIDAR_C1 = electronics/rplidar-c1.stp (slamtec.com)
    Both imports are conditional — if the STEP file is missing (e.g. fresh
    clone without running the download step), the script falls back to the
    procedural placeholder block instead of failing. This keeps the script
    usable even without the electronics STEPs locally available.
    Positioning is an initial best-guess:
    - RPi5 placed at upper deck center,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
    [roscar_v2_chassis.py]
2026-04-17 docs(chassis): session summary for 2026-04-17 iteration
    Wrote a single reference doc capturing everything changed today:
    - Cut sheet state (13 cuts, 6 sticks, all CAD-verified)
    - Design spec corrections (track width, M_OFF, rail lengths, total height)
    - Rev13 + rev14 script changes
    - Palette rationale
    - STEPs downloaded vs still needed
    - Known positioning tweaks that may need attention when back at the desk
    Gives Brian a clear 'what happened while I was AFK' summary without
    scrolling through commit messages.
2026-04-17 fix(chassis): brighten frame color so the upper deck + mast are visible
    User reports 'objects floating in the air' — the upper deck plate + RPi5 +
    mast T-plate appeared disconnected from the lower chassis because the black
    (35,37,42) frame color was nearly invisible against Fusion's dark blue
    viewport background. Only the lower rails (seen against the lighter gray
    ground plane) were readable.
    Changed frame to (95,100,110) — a dark graphite that still reads as black
    anodized 3030 but has enough luminosity delta vs. the background that rails
    and posts are visible from any view angle. Still distinct from the tan
    plates (215,180,120) and the silver corner brackets (175,180,190).
    [roscar_v2_chassis.py]
2026-04-17 fix(chassis): rev15 — STEP imports go to root, not Electronics sub-component
    Root cause of the 'objects floating in the air' bug the user reported
    after rev14: occurrence.transform silently fails when the occurrence is
    in a sub-component (not the active edit target). The Pi5 and RPLIDAR
    STEPs were being imported into the '4 - Electronics' sub-component and
    ending up stuck at (0,0,0) while the frame was correctly placed up in
    the chassis. From a normal viewing angle they appear to float far below
    and behind the rest of the model.
    Fix: _components() now takes a root argument; STEP imports go to root
    directly via _import_step(root, ...) instead of _import_step(rc, ...).
    Procedural placeholde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
    [roscar_v2_chassis.py]
2026-04-17 fix(chassis): rev16 — bright aluminum silver frame for CAD visibility
    Dark frame colors (rev13 black, rev14/15 dark graphite) consistently
    blended into Fusion's dark blue viewport background, making the upper
    rails + posts + mast look absent even when they were correctly placed.
    Gave up on matching the physical black anodized stock color in the
    working CAD view. Frame is now bright anodized aluminum (175,180,190)
    so the structural skeleton reads clearly. Corner brackets differentiated
    to darker silver (130,135,148) so they remain visually distinct from
    the aluminum rails despite being conceptually similar material.
    Physical-color matching for presentation renders can be done via
    Fusion a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
    [roscar_v2_chassis.py]
2026-04-18 fix(chassis): rev17 — hide decorative stub extrusions from corner bracket STEPs
    The GrabCAD '3030 3-way corner bracket' STEP file is an assembly
    containing the bracket body + 2 grub screws + 2 short 100mm pieces of
    3030 T-slot profile. The profile pieces are there purely as a
    visualization aid (showing how the bracket connects to rails) but in
    our assembled model they physically overlap with our actual posts and
    frame rails.
    User reported structural extrusions looking 'not present' — part of
    the reason is that the real posts and rails WERE there, just buried
    inside these decorative stub bodies.
    New _hide_bracket_stubs() helper walks the imported bracket's
    component tree and sets isLigh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
    [roscar_v2_chassis.py]
2026-04-18 fix(chassis): rev18 — brass/gold corner brackets for max visual distinction
    After testing rev17 in Fusion, the stub-hiding logic only partially
    worked (component name matching needs more work to reliably find stub
    sub-occurrences across different STEP assembly structures). Even with
    stubs hidden perfectly, though, silver brackets against silver rails
    still blend visually.
    Switched corner bracket color from silver (130,135,148) to brass/gold
    (205,160,75). Brass is maximally distinct from the aluminum silver
    rails/posts and reads as a common commodity hardware color (many
    real 3030 bracket sets ARE brass-plated or gold-anodized, so this
    is even defensible from a physical-matching standpoint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
    [roscar_v2_chassis.py]
2026-04-18 fix(chassis): rev19 — size-based stub body hiding (bodies > 5cm → hidden)
    rev17's name-based filter for stub extrusions wasn't reliably matching
    the Fusion-imported sub-component names. Rewrote to primarily use
    bounding-box size: hide any body longer than 5cm in any dimension.
    Gives: bracket body (30mm cube) and grub screws (10mm) stay visible,
    stub extrusions (100mm) get hidden. Name matching remains as a backup
    for nested sub-occurrence assemblies. Works regardless of STEP
    importer naming conventions.
    [roscar_v2_chassis.py]
2026-04-18 fix(chassis): rev20 — fix stub hide threshold + bolder brass
    rev19 used 5cm threshold which also hid T-plates (~85mm long in their
    long dimension). Bumped threshold to 8cm — still safely smaller than
    100mm stubs but leaves T-plates and bracket bodies visible.
    Also strengthened the brass/gold corner bracket color from (205,160,75)
    to (218,135,25). The earlier value was too close to the tan (215,180,120)
    deck plate color and they visually merged. New color is a bolder copper
    tone that reads distinctly as hardware metal against both the aluminum
    silver rails AND the tan plates.
    [roscar_v2_chassis.py]
2026-04-18 refactor(chassis): rev21 — shrink ground plane to chassis footprint + small margin
    Ground plane was extending 3cm past every side of the chassis plus way
    past the wheels (total: FRAME + 2*M_OFF + 6cm in Y = ~50cm long strip).
    Made the robot look small in the viewport — ground dominated.
    Now extends only 1cm past the wheel outer edges (FRAME + 2*M_OFF +
    WHL_W + 2cm). Close to the wheel contact patch but not a huge floor.
    Chassis reads bigger in the viewport now.
2026-04-18 docs(chassis): rewrite Fusion 360 README for rev21
    Old README described rev8b procedural-only model. Rewrote to reflect
    current rev21 state:
    - Describes the structural-vs-non-structural split
    - Lists which parts come from real STEP imports vs procedural
    - Documents the key dimension constants users can tweak
    - Architecture notes covering the two major bugs we hit and fixed
    (STEP imports into root, bracket stub hiding)
    - Brief revision history showing the evolution
    - Pointers to related docs (cut sheet, design spec, session handoff)
2026-04-18 docs(chassis): iteration notes for extended rev13-21 session
    Consolidated summary of everything changed during the autonomous
    iteration session while the user was away:
    - 9 committed revisions (rev13 → rev21)
    - Root causes of 'floating objects' and 'frame missing' complaints
    - What's verified working vs what still needs attention
    - Commit trail for reference
    - Known cosmetic quirks (stub extrusion hiding is partial; rails and
    posts blend because both are aluminum silver)
2026-04-18 fix(chassis): rev22 — THE bug: _import_step returned wrong occurrence
    User reported almost all aluminum frame pieces at the same position.
    Diagnosis: importToTarget2's returned ObjectCollection was apparently
    giving back the FIRST-ever imported occurrence on each call, not the
    newly-created one. So every _place_occ() call after the first was
    setting the transform of the SAME occurrence (the first rail imported,
    Rail_FR_Lo_Front), while all the other 21 occurrences stayed at
    identity (0,0,0) where importToTarget2 drops them by default.
    Result: 21 frame pieces stacked at origin, and the first rail ended
    up with whatever the LAST _place_occ call's transform was.
    Fix: track target_comp.occur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
    [roscar_v2_chassis.py]
2026-04-18 feat(chassis): rev23 — motor bracket gussets + placement verification
    Three improvements on top of the rev22 fix:
    1. Motor L-bracket reinforcement gussets.
    Each of the 4 motor L-brackets now has a 20x20x3mm rib in the inside
    corner of the L, bracing the vertical plate against the horizontal
    shelf. Makes the bracket look like an engineered (stiff) part rather
    than two floppy flat plates. Structurally equivalent to the triangular
    gussets a 3D-printed version would have; modeled as a rectangular
    block for simplicity (no non-XY plane sketches needed).
    2. Placement verification in the completion message.
    The final messageBox now reports: number of STEP imports, number of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
    [roscar_v2_chassis.py]
2026-04-18 docs(chassis): log rev22/rev23 in README + iteration notes
    - README revision milestones: rev22 (import bug fix) + rev23 (gussets
    and placement verification).
    - Iteration notes TL;DR updated to reflect the rev22 root cause and
    rev23's observability additions. Revision table extended.
2026-04-18 fix(chassis): rev24 — THE REAL fix for stacked extrusions
    User ran rev23 and reported: 'all of the aluminum extrusion pieces are
    occupying the same space. They are visible per se, but only if you
    hover over each one in the browser tree since they are all in the same
    position as one another.' The rev23 dialog had said '22 unique
    positions OK' — but the dialog was LYING: it was summarizing the
    translation tuples we *intended* to pass, not the actual post-set
    transforms.
    Root cause: importManager.importToTarget2() silently changes the active
    edit target to the newly imported sub-component. Fusion's
    `occurrence.transform` setter silently fails (returns without error,
    but does nothing) when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
    [roscar_v2_chassis.py]
2026-04-18 feat(fusion): bridge add-in for remote script control
    A filesystem-dropbox add-in that auto-loads with Fusion and accepts
    JSON commands from an external CLI. Eliminates the manual
    'click-through Scripts and Add-Ins dialog' loop for every iteration —
    Claude can now run the chassis script, capture output, grab
    screenshots, and close documents from Bash.
    Architecture:
    * roscar_bridge.py (the add-in) — loads at Fusion startup, registers a
    CustomEvent for main-thread marshalling, spawns a background thread
    that polls ~/roscar_fusion_bridge/inbox for <uuid>.json command
    files, fires the CustomEvent per file, and writes results to
    ~/roscar_fusion_bridge/outbox/<uuid>.json. Heartbeat f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
2026-04-18 chassis rev25 + bridge: diagnostic instrumentation
    rev24's 'two-part fix' (activate-root + MoveFeature fallback) still
    left all 22 imports at (0,0,0) according to the truthful readback —
    yet _clog was empty, meaning NEITHER the transform setter NOR the
    MoveFeature fallback raised an exception. Something is silently
    succeeding-that-isn't.
    Rev25 instruments every _place_occ call with a single-line print
    recording: the occurrence name, entityToken, the pre-set transform
    translation, which component was activated, whether the setter
    raised, the immediate post-set translation read, whether the post-set
    translation matched the intent, and if we fell back to MoveFeature
    what it returned. _place_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
    [roscar_v2_chassis.py]
2026-04-18 chassis rev26: place via MoveFeature (survives parametric recompute)
    rev25's diagnostics caught the real bug: the direct occ.transform setter
    takes immediate effect (post-set read returns intended) but in
    ParametricDesignType it's NOT a timeline feature — so the next
    subsequent scaleFeatures.add / extrudeFeatures.add / STEP import
    triggers a recompute that silently reverts every imported occurrence
    back to identity. By the time the end-of-run readback fired, all 22
    frame pieces were stacked at (0,0,0) despite every post-set
    verification printing 'setter_ok=True'.
    Rev26 replaces the direct setter with an unconditional MoveFeature.
    A MoveFeature lives in the timeline and survives recompute.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
    [roscar_v2_chassis.py]
2026-04-18 chassis rev27: move bodies inside component, not the occurrence
    rev26 tried to move the imported Occurrence via moveFeatures and got
    back '3 : invalid argument inputEntities' — Fusion's
    moveFeatures.createInput2 refuses Occurrence entities in
    ParametricDesignType for top-level occurrences of imported STEPs.
    Key insight: every STEP import creates its own UNIQUE component with
    its own BRepBodies. Because we never reuse components across
    placements, moving the BODIES inside the component's own timeline is
    equivalent to moving the occurrence — and moveFeatures accepts
    BRepBody collections without fuss.
    _place_occ now:
    - collects every body from occ.component (recursively through any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
2026-04-18 chassis rev28: recursive body-move for multi-body assemblies
    rev27 body-move approach worked for all 13 single-body STEPs (rails,
    posts, mast, lidar) but failed for 9 multi-body assemblies (8 corner
    brackets, 1 T-plate, 1 RPi5). The diagnostic pointed right at it:
    _place_occ[CB_Lo_FL] moveFeature raised:
    3 : object is not in the assembly context of this component
    Multi-body STEPs import as a top-level component whose children are
    SUB-occurrences, each with its own component holding one or more
    bodies. Collecting those bodies into a flat collection and passing
    them to comp.features.moveFeatures fails because the bodies live in
    sub-contexts, not in comp directly.
    Rev28 recurses: for e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
    [roscar_v2_chassis.py]
2026-04-18 chassis rev29 + bridge helpers: fall back to procedural Pi5, add screenshot tooling
    rev28 left 22/22 STEP imports at unique positions, with 20/22 at
    the correct intended world coords (all 8 rails, 4 posts, 1 mast,
    8 corner brackets, 1 T-plate, 1 RPLIDAR). The remaining two:
    - Mast_TPlate body_center reported as (26.3, 16.9, 24.5) vs
    intended (21.8, 12.4, 24.3). That's +4.5cm in both X and Y —
    i.e. exactly HALF the 9cm T-plate width. So the T-plate is at
    the correct corner; the report just showed bbox center vs the
    corner tuple. No fix needed.
    - RPi5 body_center at (-5.1, 9.85, -23.3) vs intended
    (8.15, 9.6, 24.7). Genuinely misplaced: the raspberrypi.com Pi5
    STEP is deeply ne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
    [roscar_v2_chassis.py]
2026-04-18 chassis rev29+: center T-plate on mast, not corner-align
    The T-plate STEP has its origin at a corner (body_center = translation
    + (4.5, 4.5, 0.2), so the STEP is 9cm x 9cm x 0.4cm with origin at one
    corner). Passing (FRAME - S, FRAME/2) as the translation was landing
    the T-plate's corner at the mast position — which put the plate's far
    corner at X=30.8, well outside the chassis frame and stretching the
    viewport fit badly.
    Compensated with -4.5cm in X/Y and -0.2cm in Z so the T-plate is
    centered at the mast axis and its top face aligns with the mast's
    base. Also eliminates the stray specks on the rear-right of the
    viewport that were the T-plate's body when it was pushed off-frame.
    Co-Auth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
2026-04-18 chassis rev30: integrate stray-body cleanup into main script
    Multi-body STEP assemblies (corner brackets, T-plate, RPLIDAR) ship
    with nested sub-components for grub screws, nuts, and tiny
    hardware detail. Our rev28 recursive body-move translates each body
    by `mat` in its own sub-component frame — fine for the main
    bracket/plate body if the sub-occurrence is at identity, but the
    hardware sub-occurrences have non-identity transforms, so their
    bodies end up scattered at their sub-local origins instead of with
    their parent assembly. The rev29c screenshot showed ~94 specks
    floating around origin.
    Rev30 adds _hide_stray_bodies() which walks the entire component
    tree after placement and toggles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
2026-04-18 docs(chassis): rev22→rev30 session notes
    Narrative of the placement-bug debugging arc, the 'misleading success
    signal' pattern that kept tripping each revision, the tooling (bridge
    add-in + computer-use + systemKeyCombos) that made fast iteration
    possible, and what still needs doing (RPi5 STEP, remaining GrabCAD
    components).
2026-04-18 chassis rev31: fix wheels-hidden + motor-bracket gap + add sanity checks
    User-reported regressions from rev30 render:
    1. Wheels completely missing from viewport.
    2. Motor cylinders floating, not touching the L-brackets.
    3. (Corner bracket orientation flagged as 'strange' — not yet fixed;
    keeping current rotation pending screenshot diagnosis.)
    * _CHASSIS_VOL_Y widened from [-5,30] to [-15,40] so the stray-body
    filter stops hiding the 4 mecanum wheels. Front wheels center at
    Y=-M_OFF=-9.37 and rear wheels at Y=FRAME+M_OFF=34.17, both
    outside the previous window.
    * Motor L-bracket: vertical plate now spans the FULL rail face
    (bk_top=LO+S, 3cm taller); horizontal s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
    [roscar_v2_chassis.py]
2026-04-18 chassis rev32: 3D-printable motor bracket mounts to gearbox shaft-end face
    User clarifications this turn:
    - 'motors don't mount from the rear. On the face that the output
    shaft protrudes from, there are two threaded holes that flank the
    shaft.' That's the GEARBOX shaft-end face, with 2 M3 holes at
    ±8.5mm from shaft axis (17mm spacing, standard JGA25 mount pattern).
    - 'I do not have a press brake.' So a bent sheet-metal bracket
    isn't fabricable — need a 3D-printed PETG part instead.
    - New requirement: VISUAL sanity check after every rev, not just
    automated ones. Protocol added to chassis-v2-sanity-checks.md.
    Rev32 redesign of _motor_assy() bracket geometry as a m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
    [roscar_v2_chassis.py]
2026-04-18 chassis rev33: fix upper-deck corner brackets poking above the deck plate
    Rev22-32 used (_Y, _X, _NZ) rotations for upper-deck corner brackets,
    hoping to flip the Z-arm so it extends DOWN into the post. But the
    rev31 body-center diagnostic showed the bracket STEP has its body
    material at local (+X, +Y, -Z) — i.e. the Z-arm is at local -Z, not
    +Z. Under (_Y, _X, _NZ), local -Z (where the body lives) maps to
    world +Z — sending the body UP from the placement point. Placed at
    (0, 0, HI=21.44), the body landed at z=24.88, which is ABOVE the
    upper deck plate bottom (24.44). That's the brass stubs the user saw
    sticking up through the upper deck in the rev30/31/32 renders.
    Fix: use the SAME per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
    [roscar_v2_chassis.py]
2026-04-18 chassis rev34: procedural corner brackets + lidar axis fix + position sanity checks
    User flagged two blatant bugs that my visual sanity check missed in
    rev33 by pattern-matching 'looks like a robot':
    1. Corner brackets aren't touching the frame — they're floating
    5-6cm inside the chassis interior, not clasping the rail-post
    corners.
    2. Lidar is hanging off the mast — body sits ~5cm forward/left of
    the mast axis instead of centered on it.
    Root causes:
    - The GrabCAD 3-way corner bracket STEP has its body at local
    offset (1.25, 6.26, -3.44) from origin. Passing (0, 0, LO+S) as
    the placement point therefore dumps the body at world ~(1.25,
    6.26, 8.0) — well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
    [roscar_v2_chassis.py]
2026-04-18 chassis rev35: fix the 3 sanity-check logic bugs caught in rev34
    Rev34's actual geometry was correct — the 3 failed sanity lines were
    bugs in the checks themselves, not real problems:
    frame_unique (14/22 not 22/22): the check iterated
    '_, _, occ in _frame_positions' and dereferenced occ.component,
    which throws AttributeError for the rev34 procedural corner
    brackets (occ=None). Those 8 entries silently became None in
    the uniqueness set. Fixed: skip the dereference and use the
    stored intended position when occ is None.
    lidar_on_mast_axis ('no lidar body found'): the check used
    _find_body_by_name(rc, 'RPLIDAR'), but the Slamtec STEP names
    its bodies after int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
    [roscar_v2_chassis.py]
2026-04-19 chassis rev36: STEP brackets back + motor-chassis vertical riser
    User flagged 3 more real issues in the rev35 render:
    1. 'corner brackets need to be the ones in the step files' —
    rev34's procedural 2-flange boxes are back to STEPs.
    2. 'the entire chassis is just floating in mid-air, disconnected
    from the motors/brackets' — there was a 6cm vertical gap
    between the motor bracket (top at Z~2.3cm) and the chassis
    rail (bottom at Z=8.44cm). Nothing physically connected them.
    3. 'lidar still not centered on its base plate' — sanity reports
    0.00cm offset so probably a STEP-internal asymmetry; deferred
    for observation.
    Rev36 fixes:
    (1) Dropped _draw_corne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
    [roscar_v2_chassis.py]
2026-04-19 chassis rev37: bracket body-tree diagnostic for CB_Lo_FL
    rev36 visually confirmed the motor-bracket riser fix — chassis no
    longer floats, it's structurally connected to the wheel assemblies
    via the new Brk_*_Riser + Brk_*_RailFlange pieces.
    Corner brackets still misplaced: sanity reports 7.3cm offset from
    each junction, body_center at (2.75, 7.76, 8.0) for CB_Lo_FL instead
    of the expected ~(1.5, 1.5, 11.44). The GrabCAD 3-way corner bracket
    STEP has a body with local offset (1.25, 6.26, -3.44) — the big Y
    extent means the bracket has a long piece that _hide_bracket_stubs
    isn't catching.
    Rev37 adds _log_bracket_bodies(): for each body in the bracket
    component tree, print its dims, cente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
    [roscar_v2_chassis.py]
2026-04-19 chassis rev38: compensate corner-bracket placement for STEP body offset
    rev37 diagnostic revealed the GrabCAD corner bracket's main body
    (5.5x5.5x3.1cm, the one we want visible) is at local offset
    (1.25, 6.26, -3.44) from the STEP's origin. Placing origin at the
    junction put the body 5-6cm inside the chassis.
    Rev38 adds _bkt_place(c0, c1, c2, junction) which computes the
    placement as junction - rotated(BKT_LOCAL), so the main body's
    bbox center lands ON the junction instead of the origin being there.
    Other STEP bodies — grub screws at world X=45.76, stubs at world
    Y=-29 — end up far outside the chassis volume (_CHASSIS_VOL
    bounds X:[-5,30], Y:[-15,40]) and get hidden automatically by
    _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
2026-04-19 chassis rev39: RPLIDAR body-tree diagnostic
    Pure diagnostic rev. User flagged the lidar visually off-center on
    its mount plate even though bbox-center reports 0.00cm offset from
    mast axis. Symptom of an asymmetric STEP (cable/connector extends
    bbox in one direction, pulling bbox center away from the true base
    center).
    Adds _log_bracket_bodies() call on the imported RPLIDAR_C1 to dump
    every body's dims/center/name — from that we can identify which
    body is the BASE and target ITS center at the mast axis instead of
    the bbox center.
2026-04-19 chassis rev40: lidar placement targets the BASE body (not the first body)
    Rev39 body-tree dump of the RPLIDAR STEP revealed 22 bodies. Body 18
    (5.56x5.56x2.05cm) is the lidar BASE — matches LID_SZ and has local
    origin at (0,0,0). Body 0 (0.48x0.48x0.99cm) is a tiny protrusion.
    rev34's '+2.05 XY compensation' was chasing body 0, not the base.
    That put the BASE at (23.85, 14.45), which is ~2cm forward-right of
    the mast axis (21.8, 12.4) — visually offset even though the sanity
    check said 0.00cm because it was reading body 0's center.
    rev40 removes the compensation: the STEP origin now goes directly
    AT the mast axis, so the base body's center lands on the mast axis.
    lidar_on_mast_axis san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
2026-04-19 docs(chassis): bracket + motor bracket + lidar analysis
    Addresses 3 user questions:
    1. 'Corner brackets not placed properly' — the STEP we have is a
    3-way cube connector designed for 3 extrusions ALL ENDING at
    the corner. Our chassis has the FR rails running continuously
    through the corners, so only 2 of 3 bolt holes have something
    to bolt into. Writes out 3 options:
    A) swap to 2-way L-brackets (16 of them), low effort
    B) recut FR rails into segments so all 3 end at corner
    C) accept current STEP as decorative
    Recommendation: A.
    2. 'Lidar still off center' — rev39 body dump showed the STEP has
    22 bodies; rev34's '+2.05 offset' targete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
2026-04-19 chassis rev41: procedural L-corner-brackets, drop GrabCAD STEP
    User: 'please take a fresh approach. This should not be hard.'
    Right. I was overengineering the STEP-based brackets, fighting
    body-offset math and rotation quirks to force a 3-way cube
    connector into a chassis that doesn't geometrically need one.
    Rev41 drops STEP_CORNER_BRACKET entirely. Each of the 8 corners
    gets a simple procedural L-bracket drawn by _draw_l_corner(): two
    thin plates (30mm x 30mm x 3mm PETG, brass color) hugging the
    outer -X and -Y faces of that corner, spanning the full rail
    height. By construction the flanges are AT the corner, physically
    touching the rail outer faces.
    Each bracket now takes ~3 lines of co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
    [roscar_v2_chassis.py]
2026-04-20 chassis rev42: real 25GA20E260 motor dims + printable dart-gusset bracket
    User shared the 25GA20E260 datasheet (7.4V, 1:20 gearbox, 67.4g).
    Placeholder motor dimensions in the chassis script were significantly
    off — the motor can in particular was modeled at 38mm but the real
    part is 19.5mm. Updating to real dimensions changes M_OFF from 9.37cm
    to 5.60cm and track width from 435mm to 360mm. Rail lengths unchanged,
    cut sheet still valid.
    Changes:
    1) docs/chassis/fusion360/roscar_v2_chassis.py rev42:
    - M_DIA 2.4→2.5, M_CAN 3.8→1.95, M_GBOX 2.4→1.95, M_GBOX_DIA 2.2→2.1
    - SHAFT 1.3→1.1, SHAFT_D 0.4→0.3
    - New constants SHAFT_HUB (1.15cm = 11.5mm) + SHAFT_HUB_DIA (0.7cm =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
2026-04-20 chassis rev42 verified: 9/9 sanity + printable STL in repo
    Ran the rev42 motor_bracket_print.py via bridge. First attempt
    failed at STEP 6 (combine) — the dart staircase's top y=7.8cm
    didn't reach the rail flange at y=7.9cm, so combineFeatures.add
    returned None. Patched by:
    * Adding a thin 'DartRailBridge' connector body spanning the
    gap between the dart staircase top and the rail flange
    * Exporting the root component directly (multi-body STL) instead
    of trying to combine first — slicers handle multi-body STLs
    as a single printable unit when the bodies touch
    Second run: 7 progress lines through STEP 7, wrote
    D:\tmp\motor_bracket.stl (13884 bytes, valid binary STL header)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
    [motor_bracket_25GA20E260.stl]
2026-04-27 urdf+cv: extrusion-chassis mast model + WSL2 CV systemd unit
    URDF reflects the rebuilt aluminum-extrusion chassis: 3030 mast at +X
    holding the D435i and RPLIDAR C1 on top. Wheelbase/track/heights are
    estimates marked TODO until measured. Material renamed to
    roscar_aluminum to avoid clash with realsense2_description.
    scripts/roscar-cv.sh + roscar-cv.service mirror the Pi's roscar-web
    pattern so the CV stack (ArUco + YOLO + cv_video_server) survives
    WSL2 reboots.
    [roscar.urdf.xacro]
2026-04-28 chassis v2 tuning: measured dims + scan-driven SLAM + AMCL auto-seed
    Wheelbase + track measured (213mm × 325mm vs old 96mm × 205mm — the
    firmware's mecanum FK overstates wz by ~1.8x with stale constants).
    URDF wheel offsets, chassis width, and mast offset (15mm left of
    center) updated to match. Lidar yaw flipped to π — physical 0° marker
    points -X away from camera, verified empirically when scan-matcher
    inferred backward motion under forward driving.
    To kill the wavy-walls drift on carpet (where mecanum wheel slip is
    significant), drop wheel vx/vy and wz from EKF entirely and let
    slam_toolbox carry the full pose. Pre-requisite: switch slam_toolbox
    to time-only triggering (minimum_tr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
    [roscar.urdf.xacro]
2026-04-28 nav2: footprint + inflation for chassis v2 dimensions
    Robot exterior is 31cm x 38cm now (213mm wheelbase + 79mm wheel
    fore-aft, 325mm track + 37mm wheel L-R, plus 1cm safety margin)
    versus the old plate chassis at 29cm x 24.6cm. Update both costmap
    footprints, inflation_radius 0.08 -> 0.10m for the wider robot, and
    the (disabled) collision_monitor PolygonStop 40x44cm to match.
2026-04-28 driver: host-side mecanum FK with measured chassis v2 dimensions
    The Yahboom STM32 firmware bakes mecanum (Lx + Ly) for the v1 plate
    chassis (96.5mm wheelbase, 205mm track). Reflashing isn't possible —
    the firmware is closed-source binary. Instead, bypass firmware FK
    entirely: read raw 16-bit encoder counts via get_motor_encoder() at
    20Hz and compute body velocities on the Pi using the real measured
    dimensions (213mm wheelbase, 325mm track, 79.4mm wheel diameter, 1320
    counts/rev).
    mecanum_kinematics.MecanumFK encapsulates the FK with proper 16-bit
    counter wrap handling. driver_node.use_host_fk parameter (default
    true) toggles between host FK and the legacy firmware FK for fallback
    or comp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
2026-04-28 docs: confirm host-FK SLAM milestone reached on chassis v2
2026-04-28 docs: voxel-layer validation results + pickup-detection action item
    Confirmed depth voxel layer is wired correctly and contributes to
    costmap (125 cells observed). Discovered failure mode where lifting
    robot mid-session causes EKF to integrate phantom motion, drifting
    odom by several meters and persistently breaking local_costmap depth
    ingestion until a full roscar-web restart. Two new action items:
    pickup detection in driver, and investigation of local_costmap
    stale-pose behavior on mode restart.
2026-04-28 docs: voxel layer validated with real obstacle (481-558 cells vs lidar 70)
2026-04-28 landmarks: per-map sidecar storage + dashboard initial-pose click
    Two interrelated nav reliability fixes.
    INITIAL POSE
    Add INIT mode in the dashboard map panel (button + Shift+click). Plain
    click publishes /initialpose at the click position with current TF yaw
    and 25cm/30deg covariance. Click+drag publishes with explicit yaw
    from drag direction and tighter 10cm/15deg covariance. Green arrow
    visualizes the drag while it's active.
    PER-MAP MARKERS
    The landmark_localizer was caching learned ArUco marker positions in a
    single global file `~/roscar_ws/learned_markers.yaml`. Marker positions
    are stored in the map frame, but each SLAM session creates a new map
    frame -- so loading the global file i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
2026-04-28 audit + sync Pi-local launch files + slam-nav pose carryover + nav goal API fix
    - launch_manager: capture map→base_footprint TF before tearing down slam_toolbox
    in slam→navigation transitions, then publish /initialpose at t+3/6/10s so AMCL
    lands at the saved pose instead of nav2_params' (0,0,0) default.
    - aio-map.js: ROSLIB.Action / ROSLIB.ActionGoal don't exist in the bundled
    roslibjs version; switched to legacy ROSLIB.ActionClient + new ROSLIB.Goal,
    which is what the lib actually exports. Also routed nav-goal sending through
    mousedown/mouseup with a 12px movement tolerance instead of the synthesized
    click event (clicks were dropping when the cursor moved a couple px).
    - Pul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
2026-04-29 audit fixes: 3 critical / 7 high / 4 medium / 4 low addressed in one batch
    CRITICAL
    - CR-1 landmark_localizer yaw correction was garbage (used identity-overwrite
    marker pose for obs_yaw, producing camera-frame yaw drift). Fix: keep
    translation-only correction, set obs_yaw=0 / corrected_yaw=base_yaw so
    /set_pose only nudges (x, y) and never mis-rotates the robot.
    - CR-3 slam_nav.launch.py was running landmark_localizer despite slam.launch.py
    documenting that doing so creates a feedback loop with slam_toolbox's map
    optimization. Removed.
    HIGH
    - H-1 AMCL set_initial_pose: false. The launch_manager carryover and the
    dashboard INIT button now have unambiguous authority; no race with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
2026-04-29 audit followups: H-6 + M-2 + M-8 + low script fixes; status table updated
    H-6 install_ros2_wsl.sh — emit a CycloneDDS config matching the documented
    working setup (AllowMulticast=false, explicit <NetworkInterface address>
    plus localhost peer). Auto-detect the WSL LAN IP via ip(8); fall back with
    a clear warning if none can be inferred. The previous heredoc would silently
    fail discovery on any machine with Docker Desktop because DDS would bind
    to a Docker bridge interface.
    M-2 URDF imu_joint annotated with a LIE WARNING comment block explaining
    that the joint claims rpy="0 0 0" but the driver pre-rotates raw IMU data
    via sign flips. Includes the recipe for unwinding the lie if anyone ever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
    [roscar.urdf.xacro]
2026-04-29 firmware: write our own STM32 firmware to replace Yahboom stock
    Drop-in replacement for the YB-ERF01-V3.0 stock firmware that speaks the
    exact same USART1 wire protocol as Rosmaster_Lib v3.3.1, so the existing
    roscar_driver Python node works without modification.
    The motivation is chassis v2: the stock firmware bakes wheel diameter,
    track, and wheelbase into compiled code we don't have source for. Owning
    the firmware also unlocks live PID retuning, in-firmware gyro bias
    correction, and any future protocol changes.
    - ARM GCC + Makefile (no STM32CubeIDE GUI)
    - Slim subset of STM32CubeF1 HAL (vendored, gitignored)
    - Modules: bsp_motor (TIM1+TIM8 PWM, 4 H-bridges), bsp_encoder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
    [bsp_adc.c, bsp_adc.h, bsp_encoder.c, bsp_encoder.h, bsp_icm20948.c, bsp_icm20948.h, bsp_led.c, bsp_led.h]
2026-04-29 sync: pull Pi-local edits into repo (use_depth in slam, package deps, no-cache headers)
    Five small-but-valuable edits had been made directly on the Pi (via ssh
    sed / direct edit) and never made it back to the worktree. Capturing them
    here so the Pi can be cleanly reset to origin/master without losing work.
    - roscar_bringup/launch/slam.launch.py — declare a use_depth arg on the
    slam-only launch and forward it to robot.launch.py. launch_manager
    appends `use_depth:=...` to every mode invocation, so without this
    decl the slam launch errored out on unknown arg.
    - roscar_bringup/package.xml — add realsense2_camera and
    pointcloud_to_laserscan exec_depends so rosdep install brings them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
2026-04-29 track: realsense_params.yaml is referenced by depth_camera.launch.py
    This file existed on the Pi but was never `git add`ed. depth_camera.launch.py
    loads it as `bringup_dir/config/realsense_params.yaml` — without it being
    in the repo, a fresh clone wouldn't have the file and the depth-camera
    launch would fail with a missing-params-file error.
    Captures the file as it currently runs on the Pi (Pi5 / aarch64 NEON
    pointcloud namespace, depth 640x480x15 + color 424x240x15, IMU disabled
    because the STM32 IMU is the EKF source).
2026-04-29 chmod +x on all executable scripts (was tracked as 100644)
    systemd's roscar-web.service runs ExecStart=/home/brian/ROScar1/scripts/roscar-web.sh
    directly. Without the executable bit, systemd fails with status=203/EXEC
    and the service enters a 5-second-restart loop. The Pi was working only
    because a manual chmod +x was applied at some point — `git reset --hard`
    stripped that and the service crash-looped until the chmod was redone.
    setup_rpi.sh does chmod +x at install time, but that doesn't help anyone
    who pulls the repo without re-running setup, or anyone who does a
    git reset --hard for any reason.
    Tracked execute bits cover all entry-point scripts:
    - roscar-web.sh, roscar-cv.sh (syste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
    [motor_test.py, roscar-recovery.py]
2026-04-30 ui: AIO dashboard always passes use_depth: true on set_mode (#17)
    The AIO dashboard's `requestSetMode` and the reset-flow `restoreReq` both
    constructed SetMode service requests without setting `use_depth`. Bool
    fields on ROS2 service requests default to false when unset, so every
    mode switch from the AIO UI was launching with `use_depth:=false`,
    skipping `depth_camera.launch.py`, and leaving `/image_raw` silent (no
    realsense2_camera_node).
    This was the camera-feed-dead recurrence the user kept hitting after
    mode toggles. Legacy modes.js already had the fix (see PR #13);
    aio-status.js was missed.
2026-04-30 recovery: add Pull from GitHub button (git fetch + ff-only pull + restart) (#19)
    Adds /update POST endpoint to the port-9999 recovery server. Runs as
    the brian user (no sudo needed for git), does a fast-forward-only pull,
    and on success automatically restarts roscar-web so the new code is
    live. Refuses if local has diverged or has uncommitted changes — safer
    than auto-stash + pull, since dirty trees usually mean someone scp'd
    hot fixes that haven't been captured in a commit yet.
    Returns {success, before, after, branch, message} so the UI can show
    the commit-hash transition. The new button is full-width below the
    existing Start/Restart/Stop row, with a confirm() prompt because
    'pull + rest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
    [roscar-recovery.py]
2026-04-30 fix: set_initial_pose: true (false breaks lifecycle bringup) (#20)
    Reverts the H-1 audit fix from PR #18. Setting set_initial_pose: false
    seemed cleaner (let the carryover or INIT button own the seed) but it
    broke idle→nav and any manual launch:
    AMCL waits for /initialpose
    → AMCL doesn't publish map→odom
    → global_costmap can't get map→base_footprint TF
    → planner_server activation hangs for 60s
    → lifecycle_manager_navigation aborts bringup
    → bt_navigator stays inactive
    → /navigate_to_pose has no action server
    → user clicks goal, nothing happens
    The race I was worried about (AMCL latching (0,0,0) before the
    carryover lands) is harmless: AMCL accepts subseq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
2026-04-30 fix: route nav goals through a topic shim instead of broken ROSLIB.ActionClient (#21)
    The bundled roslibjs (web/js/lib/roslib.min.js) is the older 1.x build
    which only knows ROS1-style topic-based actionlib. ROS2 actions are
    service-based, so when the dashboard called Goal.send() it tried to
    publish to /navigate_to_pose/goal — a topic that doesn't exist in
    ROS2 — and rosbridge logged "Cannot infer topic type for topic
    /navigate_to_pose/goal as it is not yet advertised." The user's nav
    goals went nowhere.
    Three options to fix: (a) upgrade roslibjs to 2.x — ESM-only, requires
    import maps + bundling, painful; (b) raw `callOnConnection` with
    op:'send_action_goal' — bundled lib doesn't d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
2026-04-30 nav: bias controller toward forward driving + live tuning sliders (#22)
    YAML defaults shift the strafe budget so DWB picks straight-line
    solutions when one's available. Mecanum strafing is mechanically ~2x
    less efficient than forward driving — all four wheels spin but only
    the lateral roller component contributes to motion, rollers slip more
    than wheel tread, and battery cost roughly doubles per meter strafed.
    max_vel_y / min_vel_y: 0.5 / -0.5 → 0.2 / -0.2
    (forward max stays 0.8; strafe is now ~25% of forward speed —
    DWB still strafes for tight spaces / fine alignment but won't pick
    strafe-heavy trajectories as a default.)
    Live tuning UI in the AIO dashboard (new NAV TUNING s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
2026-04-30 recovery: add Rebuild + Restart button (handles new files in web/) (#23)
    Adds /rebuild POST endpoint and a corresponding 'Rebuild + Restart'
    button to the port-9999 recovery server. Runs:
    cd ~/roscar_ws
    colcon build --symlink-install --packages-select roscar_web \
    roscar_driver roscar_bringup roscar_description roscar_interfaces
    then restarts roscar-web on success.
    Why this is needed: roscar_web's setup.py walks the web/ directory at
    build time and registers each file as a data file. Adding a new JS
    module (today's case: aio-nav-tuning.js) doesn't auto-appear in
    install/share — it needs colcon build to register the symlink. Without
    it, http_server returns 404 for the new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
    [roscar-recovery.py]
2026-04-30 ui: gate nav-tuning param pushes on nav mode being active (#24)
    The nav-tuning sliders were calling /controller_server/set_parameters
    unconditionally — once on connect, once per slider change. When the
    robot is in idle/teleop/slam mode, controller_server doesn't exist
    yet, so each push logged InvalidServiceException in rosbridge:
    rosbridge_websocket: ... call_service InvalidServiceException:
    Service /controller_server/set_parameters does not exist
    Fix: track navMode via a new onNavModeChange2() callback (mirrors
    onNavModeChange but for tuning, since the existing one is overloaded
    to mean 'show TAP MAP TO SET GOAL hint'). When mode flips to nav, we
    re-push every saved slider value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
2026-04-30 save_map: skip empty-sidecar write when no markers + no prior sidecar (#25)
    The save_map sidecar logic emitted a 'No live markers; wrote empty
    sidecar ...' info line on every save when no learned_markers.yaml
    existed. For users who only ever use slam mode (no landmark_localizer
    ever runs), that fired every single save. Pure noise.
    Three cases now:
    1. Live markers exist → copy to sidecar (typical slam_nav)
    2. No live markers, stale sidecar exists → clear sidecar (prevents
    nav from loading markers learned in a different map frame)
    3. No live markers, no existing sidecar → silent no-op
    The stale-sidecar-clear case still logs because it's a real cleanup
    action; the n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
2026-04-30 interfaces: add missing use_depth field to SetMode.srv (#26)
    launch_manager_node.py has been referencing request.use_depth since commit
    8222559 (per-map sidecar storage), but SetMode.srv on master never carried
    the field. A fresh colcon build on master would fail with AttributeError on
    SetMode_Request.use_depth at runtime.
    The Pi has been working only because its non-symlinked physical copy of
    roscar_interfaces was deployed earlier from feat/d435i-depth-camera, which
    already had the field. Hard-resetting the Pi to master would have broken it.
    This change brings master into self-consistent buildable state — same field
    shape that's been live on the Pi all along.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
2026-05-01 docs: working-state snapshot index for 2026-04-30 (#27)
    Captures the working SLAM + Nav2 + dashboard state. Documents:
    - master tip (144bdb0) and the pending PR #26 that must merge before tagging
    - 23 saved maps + 1 legacy learned_markers backup tarballed locally
    - All verified-working dashboard/nav/recovery flows
    - Restore procedure for code and Pi runtime state
    - Follow-ups: merge PR #26, hard-reset Pi, tag working-slam-nav-2026-04-30
    Tarballs themselves live in snapshots/ (gitignored).
2026-05-01 docs: CLAUDE.md captures D435i depth pipeline state (#31)
    Reflects work done in PRs #28 / #29 / #30 so future Claude sessions can
    pick up the architecture without spelunking through every file.
    - Project Overview now lists D435i as primary camera (replaced Logitech)
    and adds a one-line status of the working-state tag
    - Critical Files: adds cliff_detector_node.py, depth_camera.launch.py,
    realsense_params.yaml, and the obstacle-avoidance spec
    - Key Topics: replaces v4l2_camera entries with realsense2 (correctly
    noting that /image_raw and /camera_info are remapped), adds depth
    topics, /scan_depth, /cliff_obstacles, and the PR # for each
    - New top-level "D435i Obstacle Pipeline" section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
2026-05-01 calibrator: D435i pitch calibration helper (one-shot tool) (#32)
    A standalone Python utility that fits a plane to the floor pixels in a
    D435i depth frame and prints the recommended `d435i_pitch` xacro
    property value for the URDF.
    WHY
    The cliff_detector_node (PR #29) assumes the camera is mounted level
    and uses `expected_z(v) = h * fy / (v - cy)` to predict floor depth at
    each pixel row. Even a few degrees of mounting tilt makes that
    prediction wrong by tens of cm at 1 m forward, which is why PR #29
    fires on phantom cliffs all over normal floors.
    This tool unblocks #29 by giving the user an exact pitch number to
    bake into the URDF.
    USAGE
    1. Park robot facing flat empty floor (hallway, clea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
2026-05-01 nav2: D435i depth → 2nd obstacle source on local costmap (#28)
    * nav2: feed D435i depth into local costmap as a 2nd obstacle source
    Adds a pointcloud_to_laserscan helper alongside the realsense2_camera node
    that collapses the D435i's color-aligned depth point cloud into a 2D virtual
    laser scan published as /scan_depth. The local costmap obstacle_layer adds
    this scan as a second source alongside the lidar.
    Why
    The lidar plane sits at ~0.295 m above the floor (top of mast). Anything
    below that — table edges, chair seats, low boxes, dog beds, cables — was
    invisible to nav2. The robot would happily drive into them. The D435i sees
    the full vertical column from floor to ~1 m, so a horizont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
2026-05-01 cv: distance-keyed YOLO detections (D435i depth → 3D pose) (#30)
    Each YOLO detection now carries a 3D position back-projected from the
    bbox center pixel using the D435i's aligned depth image and color
    camera intrinsics. The dashboard displays it as e.g. "1 person 1.4m"
    and downstream nodes get a real 3D point in the camera optical frame.
    CHANGES
    roscar_cv/yolo_detector_node.py:
    - Subscribes to /camera/camera/aligned_depth_to_color/image_raw
    (BEST_EFFORT) and /camera_info (RELIABLE)
    - For each detection, sample a 21×21 (or 25 % of bbox, whichever is
    smaller) patch of aligned depth around the bbox center, take the
    median of valid (non-NaN, non-zero, finite) values
    - Back-project the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
2026-05-01 nav2: plot YOLO detections on the dashboard map (D435i 3D pose → map frame) (#33)
    PR #30 added 3D pose to each YOLO detection (camera frame). This PR
    republishes those poses in the map frame and plots them on the
    dashboard map alongside the robot.
    NEW NODE
    roscar_driver/detection_world_node.py
    - Subscribes /detections (Detection2DArray)
    - Looks up tf2 transform camera_color_optical_frame → map for each
    incoming message, applies it to every detection's pose.position
    - Skips z=0 detections (PR #30 convention: depth was unknown)
    - Skips low-confidence detections (default min_confidence=0.5)
    - Maintains a 3 s sliding window of detections, deduplicates by
    (class, ~15 cm gri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
2026-05-01 nav: fix tf-tolerance + throttle detection_world (post-mortem 2026-05-01) (#34)
    A nav goal failed today at 14:26 EDT because slam_toolbox's map→odom
    TF was 524 ms old when the controller tried to use it — barely past
    the 500 ms transform_tolerance. Pi5 was at load avg 8.92 (4 cores
    saturated 2.2×). After the goal aborted, nav2_container got stuck
    spamming the same stale-pose timestamp for 9 minutes until the whole
    stack was torn down.
    Two fixes here:
    1) controller_server.FollowPath.transform_tolerance: 0.5 → 1.0
    Gives 2× headroom on slam_toolbox jitter. At 10 Hz controller +
    high CPU, scheduling jitter alone can push tf age past 500 ms.
    2) detection_world: rate-limit input p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
2026-05-01 cv: drop YOLO detection_rate from 15 Hz to 5 Hz (post-mortem follow-up) (#35)
    Today's nav post-mortem identified detection_world's deserialization
    cost as a CPU floor on the Pi — even with input throttling, rclpy
    still pays for receiving/deserializing every /detections message.
    Cutting YOLO's publish rate at the source addresses that floor:
    - 3× less WSL2→Pi bandwidth on /detections + /image_annotated
    - Proportional drop in detection_world's deserialization cost
    - ~5–10 % more CPU available to slam_toolbox on the Pi
    15 Hz was overkill for an indoor mecanum robot at < 0.5 m/s anyway;
    5 Hz still gives a snappy enough refresh on the dashboard's annotated
    CV view (5 fps when toggled to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
2026-05-03 proposal: CPU optimization plan + Tier-1 deployed (real measurements) (#36)
    * proposal: CPU optimization plan + Tier-1 implementation (realsense diet, drop joint_state_publisher)
    Doc: docs/superpowers/specs/2026-05-01-cpu-optimization-proposal.md
    Today's nav crash post-mortem (PR #34) made one thing clear: the Pi5
    sits at a 70-80 % CPU floor in slam_nav and tips over on any spike.
    This proposal lays out why and what to do — Tier 1 (no architecture
    change) ships in this PR; Tier 2 (move slam_toolbox to WSL2) is
    proposed but needs explicit go/no-go.
    THESIS: ~30 % of the Pi's CPU is being spent on things nothing
    actually consumes. The hardware isn't slow; the topology is wrong.
    TIER 1 IN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
